cjsatuforc/QsP/README

3D Printer main driver board incorporating Atmel XMEGA. Inspired by RUMBA and other RepRap projects.
