cjsatuforc/QsP/mainboard.pdf

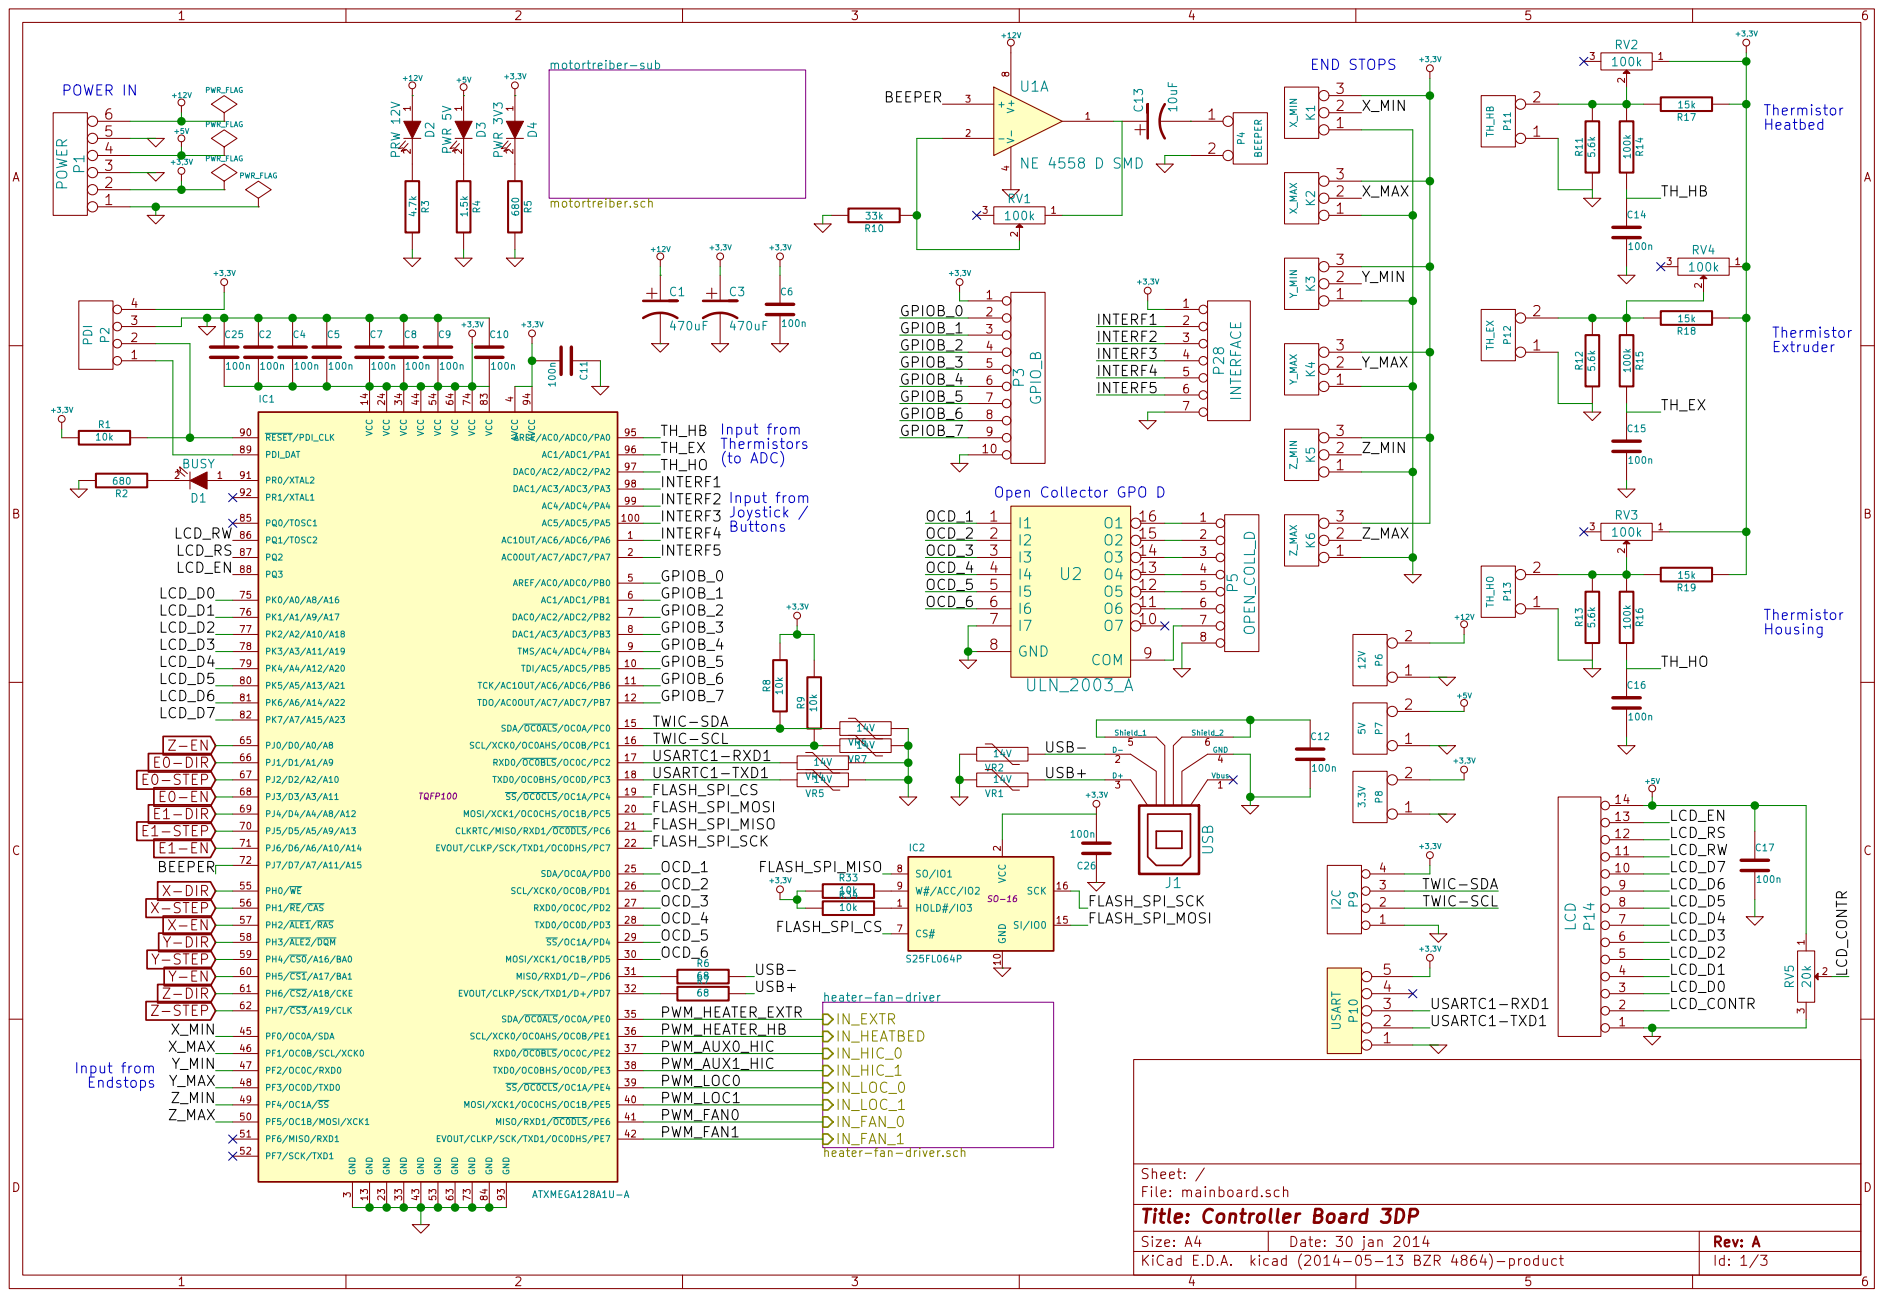
[picture p1: page 1]

+3,3V Thermistor Heatbed Thermistor Extruder Thermistor Housing

INTERF3 | 4
INTERF4 | 5

+12V heater-fan-driver heater-fan-driver.sch

2 CS# 7 SO/IO1 8 W#/ACC/IO2 9 GND 10 SI/IO0 15 SCK 16

PWM_AUX1_HIC
PWM_LOC0
PWM_LOC1
PWM_FAN0

File: mainboard.sch Sheet: /
Id: 1/3 Title: Controller Board 3DP

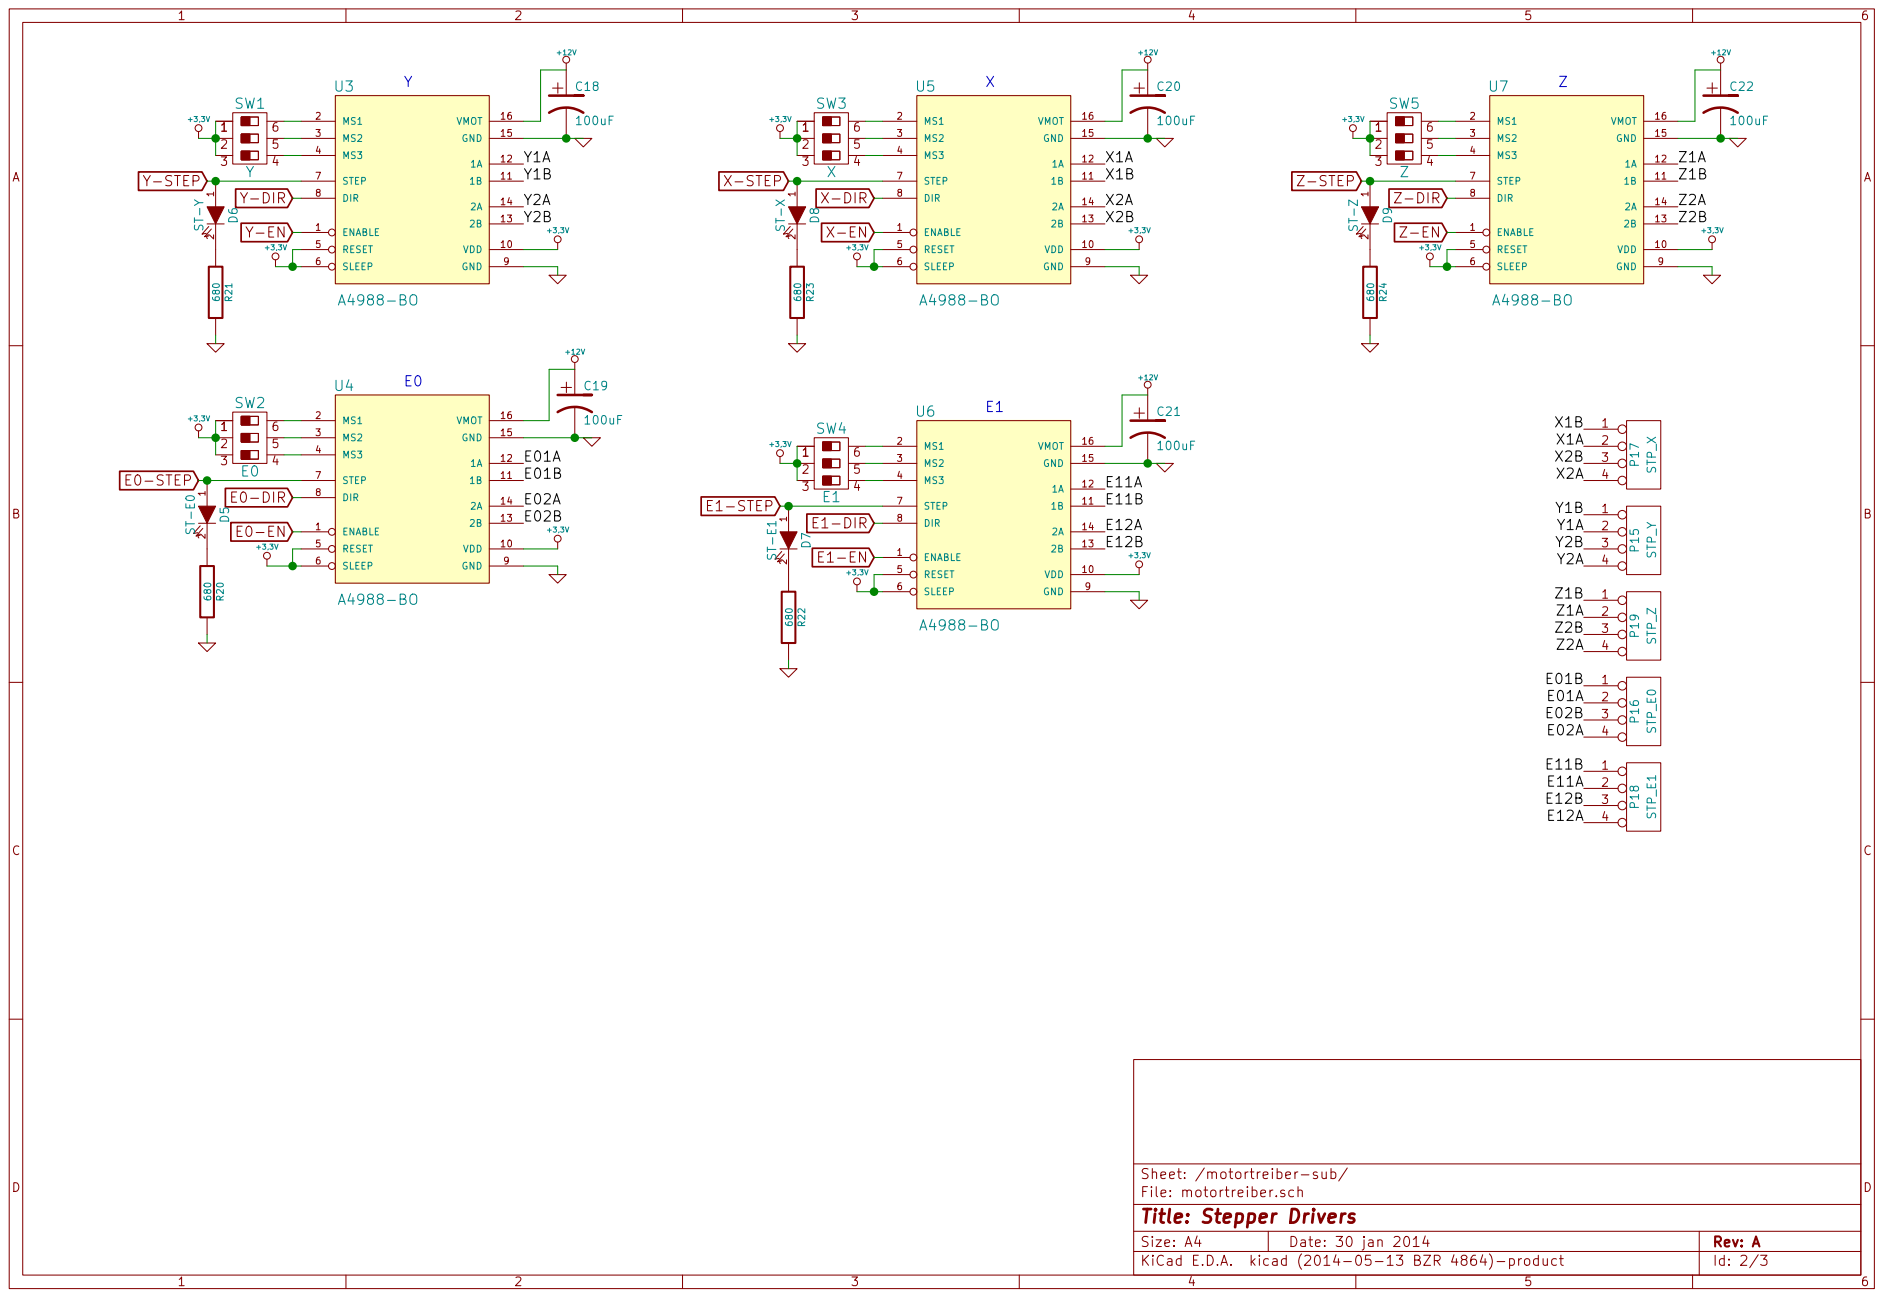
[picture p2: page 2]

File: motortreiber.sch Sheet: /motortreiber-sub/
Id: 2/3 Title: Stepper Drivers

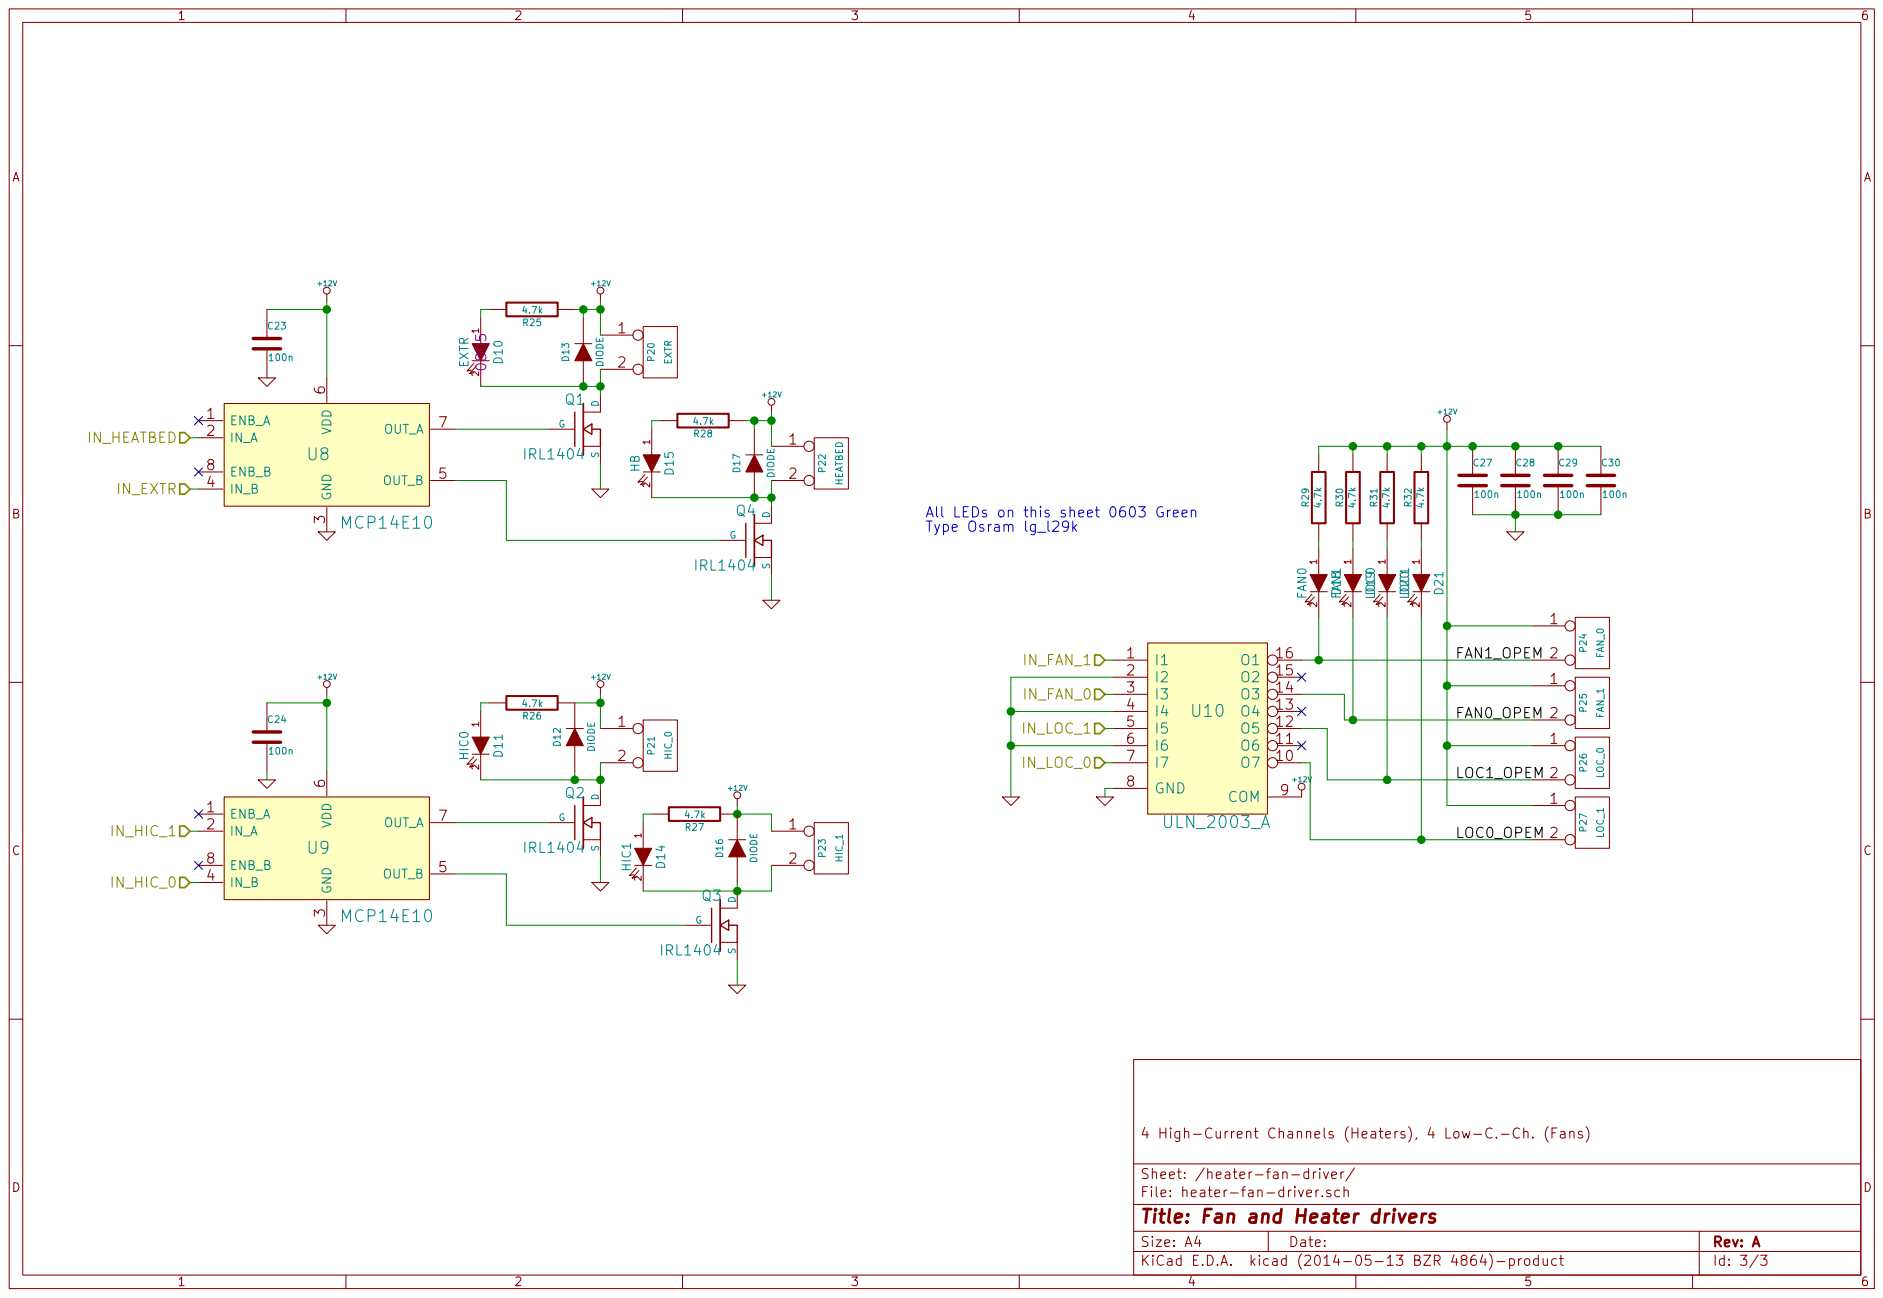
[picture p3: page 3]

All LEDs on this sheet 0603 Green

File: heater-fan-driver.sch Sheet: /heater-fan-driver/ 4 High-Current Channels (Heaters), 4 Low-C.-Ch. (Fans)

Id: 3/3 Title: Fan and Heater drivers
