cjsatuforc/QsP/mainboard-brd.pdf

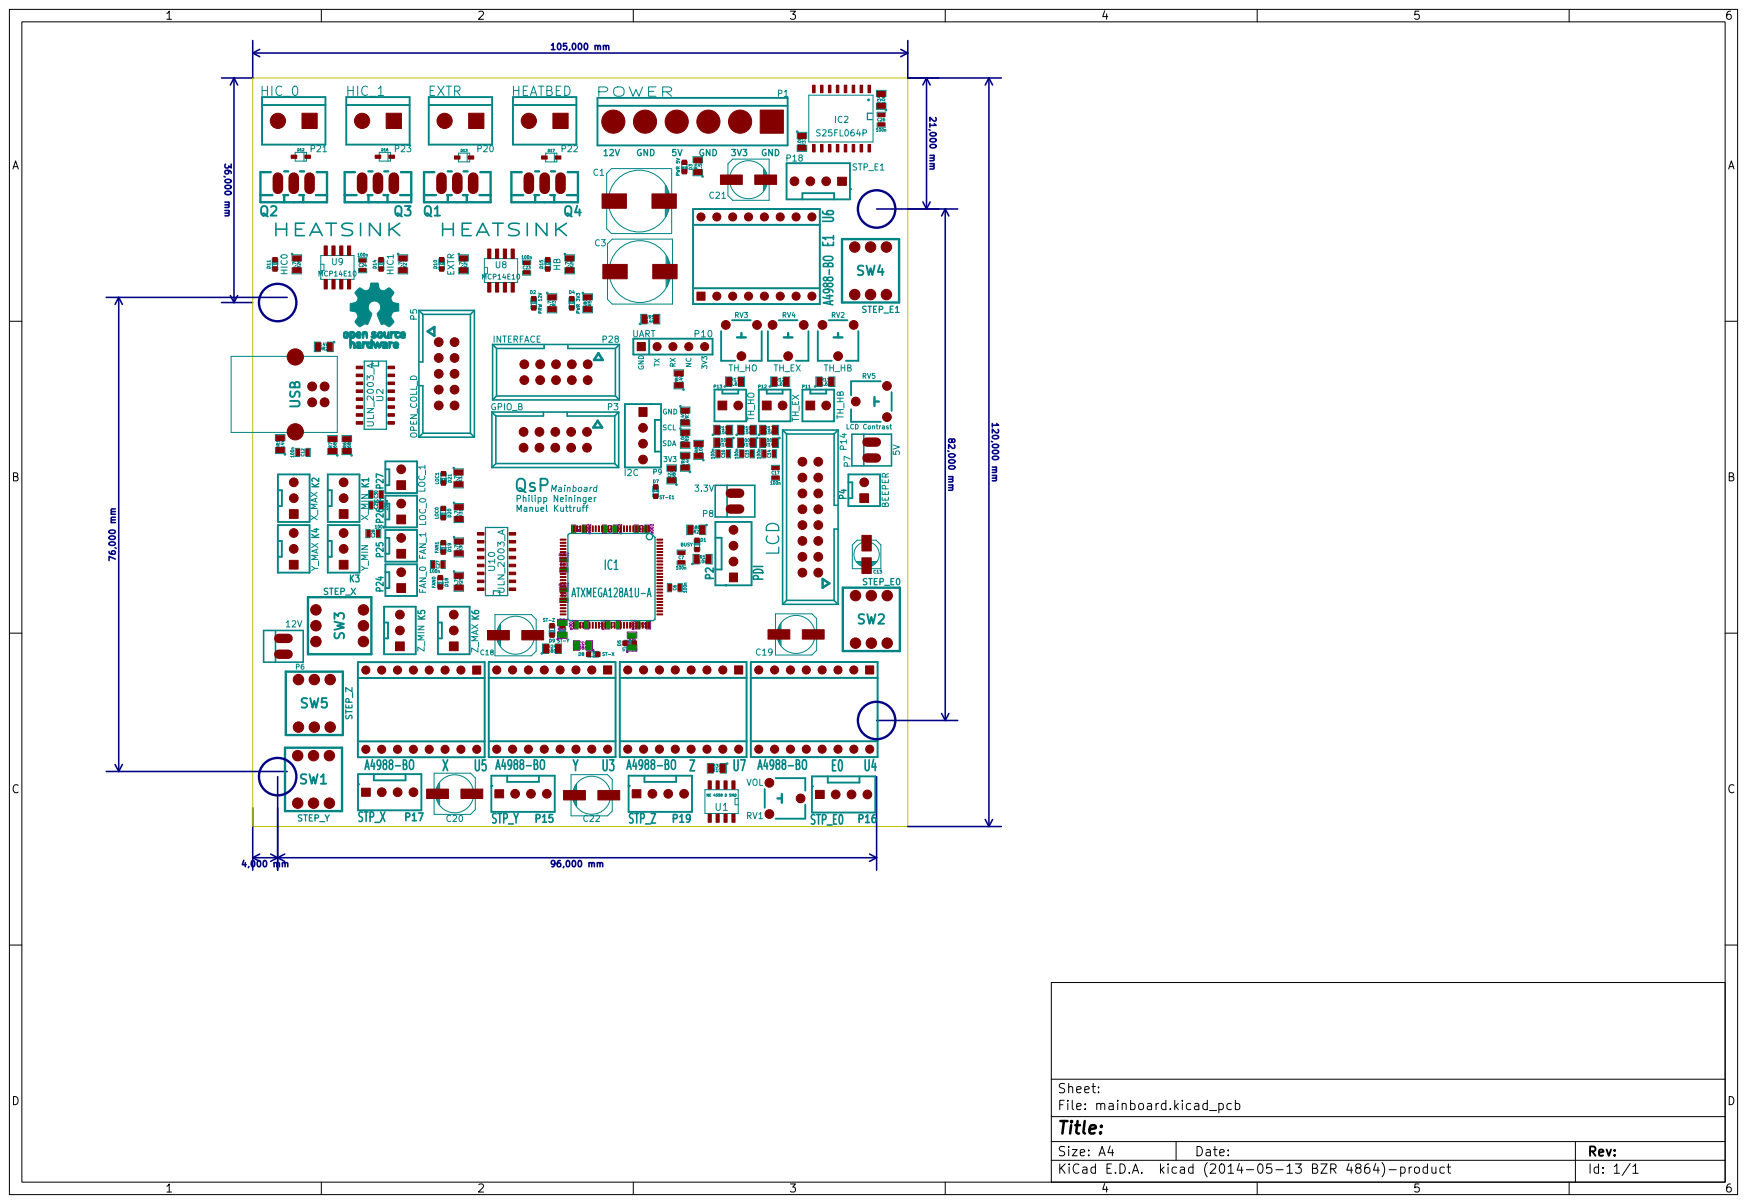
[picture p4: page 1]
