cjsatuforc/QsP/mainboard.kicad_pcb

## KiCad design mainboard.kicad_pcb (2014-08-16)

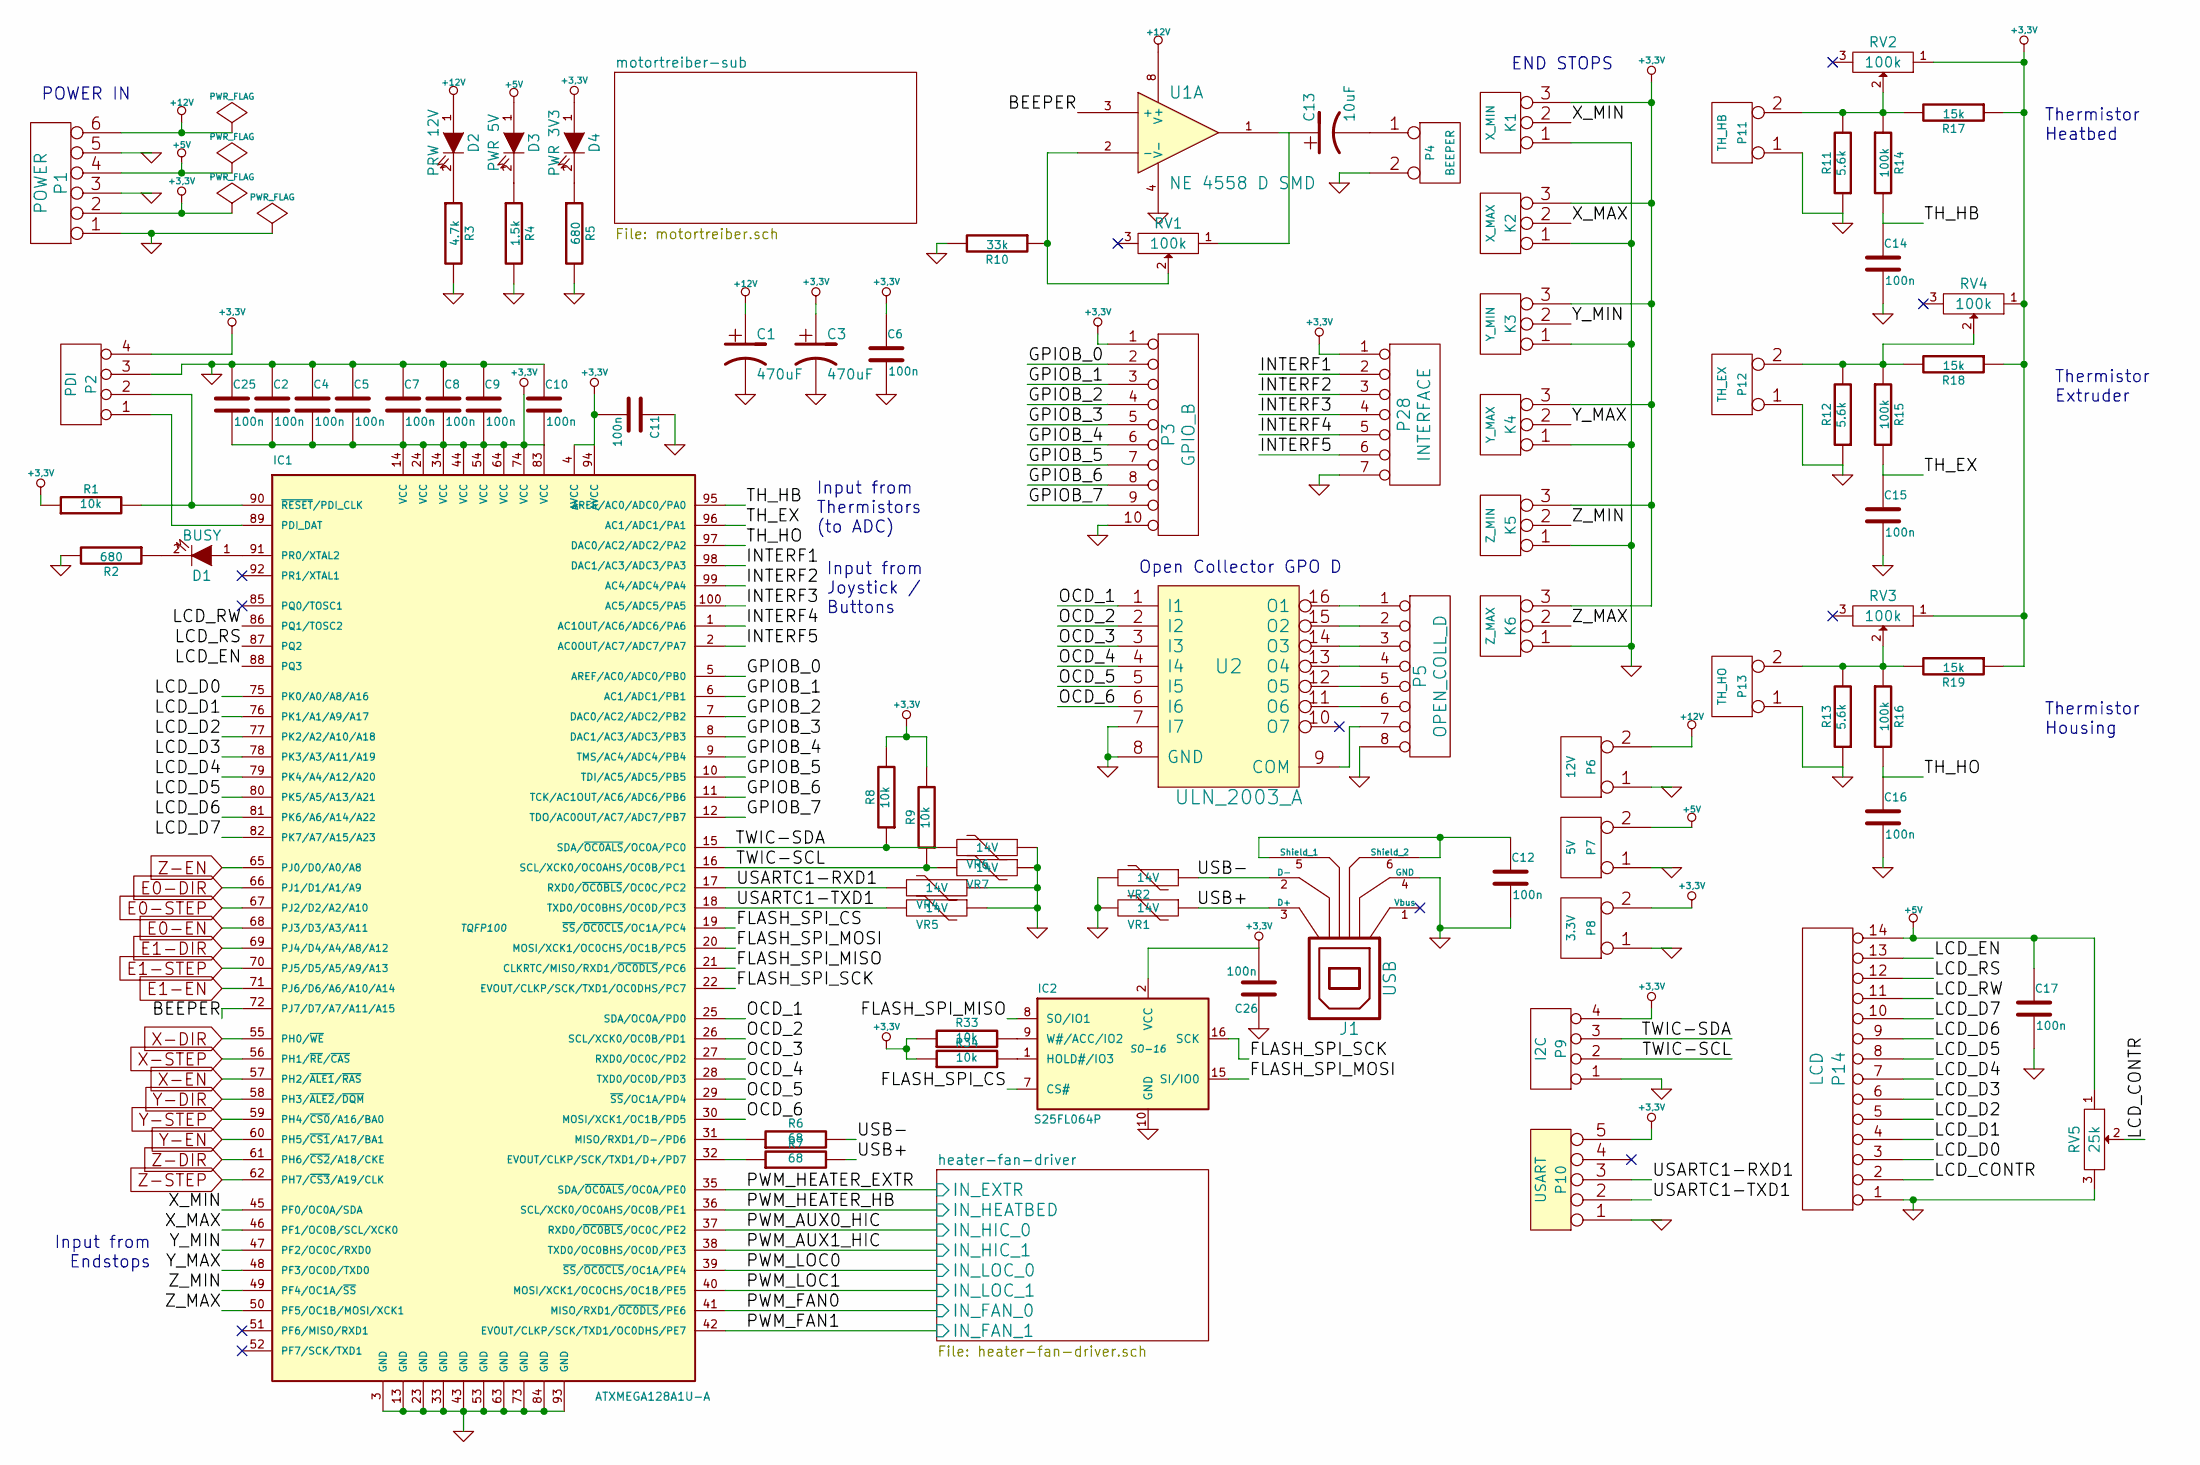
[picture p5: schematic mainboard.sch, Controller Board 3DP]

Parts:
C1, C3: 470uF
C2, C4, C5, C6, C7, C8, C9, C10, C11, C25, C26: 100n
C12, C14, C15, C16, C17: 100n
C13: 10uF
D1: BUSY
D2: PRW 12V
D3: PWR 5V
D4: PWR 3V3
IC1: ATXMEGA128A1U-A; TQFP100
IC2: S25FL064P; SO-16
J1: USB
K1: X_MIN
K2: X_MAX
K3: Y_MIN
K4: Y_MAX
K5: Z_MIN
K6: Z_MAX
P1: POWER
P2: PDI
P3: GPIO_B
P4: BEEPER
P5: OPEN_COLL_D
P6: 12V
P7: 5V
P8: 3.3V
P9: I2C
P10: USART
P11: TH_HB
P12: TH_EX
P13: TH_HO
P14: LCD
P28: INTERFACE
R1: 10k
R2, R5: 680
R3: 4.7k
R4: 1.5k
R6, R7: 68
R8, R9, R33, R34: 10k
R10: 33k
R11, R12, R13: 5.6k
R14, R15, R16: 100k
R17, R18, R19: 15k
RV1, RV2, RV3, RV4: 100k
RV5: 25k
U1: NE 4558 D SMD
U2: ULN_2003_A
VR1, VR2, VR4, VR5, VR6, VR7: 14V

Connections:
+3.3V: C2.2, C3.1, C4.2, C5.2, C6.1, C7.2, C8.2, C9.2, C10.2, C11.2, C25.2, C26.2, D4.1 (A), IC1.4 (AVCC), IC1.14 (VCC), IC1.24 (VCC), IC1.34 (VCC), IC1.44 (VCC), IC1.54 (VCC), IC1.64 (VCC), IC1.74 (VCC), IC1.83 (VCC), IC1.94 (AVCC), IC2.2 (VCC), K1.3, K2.3, K3.3, K4.3, K5.3, K6.3, P1.2, P2.4, P3.1, P8.2 (PM), P9.4, P10.5, P28.1, R1.1, R8.2, R9.2, R17.1, R18.1, R19.1, R33.1, R34.1, RV2.1, RV3.1, RV4.1; also elsewhere on the board
+5V: C17.1, D3.1 (A), P1.4, P7.2 (PM), P14.14, RV5.1
+12V: C1.1, D2.1 (A), P1.6, P6.2 (PM), U1.8 (V+); also elsewhere on the board
/BEEPER: IC1.72 (PJ7/D7/A7/A11/A15), U1.3 (+)
/FLASH_SPI_CS: IC1.19 (~SS~/~OC0CLS~/OC1A/PC4), IC2.7 (CS#)
/FLASH_SPI_MISO: IC1.21 (CLKRTC/MISO/RXD1/~OC0DLS~/PC6), IC2.8 (SO/IO1)
/FLASH_SPI_MOSI: IC1.20 (MOSI/XCK1/OC0CHS/OC1B/PC5), IC2.15 (SI/IO0)
/FLASH_SPI_SCK: IC1.22 (EVOUT/CLKP/SCK/TXD1/OC0DHS/PC7), IC2.16 (SCK)
/GPIOB_0: IC1.5 (AREF/AC0/ADC0/PB0), P3.2
/GPIOB_1: IC1.6 (AC1/ADC1/PB1), P3.3
/GPIOB_2: IC1.7 (DAC0/AC2/ADC2/PB2), P3.4
/GPIOB_3: IC1.8 (DAC1/AC3/ADC3/PB3), P3.5
/GPIOB_4: IC1.9 (TMS/AC4/ADC4/PB4), P3.6
/GPIOB_5: IC1.10 (TDI/AC5/ADC5/PB5), P3.7
/GPIOB_6: IC1.11 (TCK/AC1OUT/AC6/ADC6/PB6), P3.8
/GPIOB_7: IC1.12 (TDO/AC0OUT/AC7/ADC7/PB7), P3.9
/INTERF1: IC1.98 (DAC1/AC3/ADC3/PA3), P28.2
/INTERF2: IC1.99 (AC4/ADC4/PA4), P28.3
/INTERF3: IC1.100 (AC5/ADC5/PA5), P28.4
/INTERF4: IC1.1 (AC1OUT/AC6/ADC6/PA6), P28.5
/INTERF5: IC1.2 (AC0OUT/AC7/ADC7/PA7), P28.6
/LCD_CONTR: P14.2, RV5.2
/LCD_D0: IC1.75 (PK0/A0/A8/A16), P14.3
/LCD_D1: IC1.76 (PK1/A1/A9/A17), P14.4
/LCD_D2: IC1.77 (PK2/A2/A10/A18), P14.5
/LCD_D3: IC1.78 (PK3/A3/A11/A19), P14.6
/LCD_D4: IC1.79 (PK4/A4/A12/A20), P14.7
/LCD_D5: IC1.80 (PK5/A5/A13/A21), P14.8
/LCD_D6: IC1.81 (PK6/A6/A14/A22), P14.9
/LCD_D7: IC1.82 (PK7/A7/A15/A23), P14.10
/LCD_EN: IC1.88 (PQ3), P14.13
/LCD_RS: IC1.87 (PQ2), P14.12
/LCD_RW: IC1.86 (PQ1/TOSC2), P14.11
/OCD_1: IC1.25 (SDA/OC0A/PD0), U2.1 (I1)
/OCD_2: IC1.26 (SCL/XCK0/OC0B/PD1), U2.2 (I2)
/OCD_3: IC1.27 (RXD0/OC0C/PD2), U2.3 (I3)
/OCD_4: IC1.28 (TXD0/OC0D/PD3), U2.4 (I4)
/OCD_5: IC1.29 (~SS~/OC1A/PD4), U2.5 (I5)
/OCD_6: IC1.30 (MOSI/XCK1/OC1B/PD5), U2.6 (I6)
/TH_EX: C15.1, IC1.96 (AC1/ADC1/PA1), R15.2
/TH_HB: C14.1, IC1.95 (AREF/AC0/ADC0/PA0), R14.2
/TH_HO: C16.1, IC1.97 (DAC0/AC2/ADC2/PA2), R16.2
/TWIC-SCL: IC1.16 (SCL/XCK0/OC0AHS/OC0B/PC1), P9.2, R9.1, VR7.2
/TWIC-SDA: IC1.15 (SDA/~OC0ALS~/OC0A/PC0), P9.3, R8.1, VR6.2
/USARTC1-RXD1: IC1.17 (RXD0/~OC0BLS~/OC0C/PC2), P10.3, VR4.2
/USARTC1-TXD1: IC1.18 (TXD0/OC0BHS/OC0D/PC3), P10.2, VR5.2
/USB+: J1.3 (D+), R7.2, VR1.1
/USB-: J1.2 (D-), R6.2, VR2.1
/X_MAX: IC1.46 (PF1/OC0B/SCL/XCK0), K2.2 (PM)
/X_MIN: IC1.45 (PF0/OC0A/SDA), K1.2 (PM)
/Y_MAX: IC1.48 (PF3/OC0D/TXD0), K4.2 (PM)
/Y_MIN: IC1.47 (PF2/OC0C/RXD0), K3.2 (PM)
/Z_MAX: IC1.50 (PF5/OC1B/MOSI/XCK1), K6.2 (PM)
/Z_MIN: IC1.49 (PF4/OC1A/~SS~), K5.2 (PM)
/heater-fan-driver/IN_EXTR: IC1.35 (SDA/~OC0ALS~/OC0A/PE0); also elsewhere on the board
/heater-fan-driver/IN_FAN_0: IC1.41 (MISO/RXD1/~OC0DLS~/PE6); also elsewhere on the board
/heater-fan-driver/IN_FAN_1: IC1.42 (EVOUT/CLKP/SCK/TXD1/OC0DHS/PE7); also elsewhere on the board
/heater-fan-driver/IN_HEATBED: IC1.36 (SCL/XCK0/OC0AHS/OC0B/PE1); also elsewhere on the board
/heater-fan-driver/IN_HIC_0: IC1.37 (RXD0/~OC0BLS~/OC0C/PE2); also elsewhere on the board
/heater-fan-driver/IN_HIC_1: IC1.38 (TXD0/OC0BHS/OC0D/PE3); also elsewhere on the board
/heater-fan-driver/IN_LOC_0: IC1.39 (~SS~/~OC0CLS~/OC1A/PE4); also elsewhere on the board
/heater-fan-driver/IN_LOC_1: IC1.40 (MOSI/XCK1/OC0CHS/OC1B/PE5); also elsewhere on the board
E0-DIR: IC1.66 (PJ1/D1/A1/A9); also elsewhere on the board
E0-EN: IC1.68 (PJ3/D3/A3/A11); also elsewhere on the board
E0-STEP: IC1.67 (PJ2/D2/A2/A10); also elsewhere on the board
E1-DIR: IC1.69 (PJ4/D4/A4/A8/A12); also elsewhere on the board
E1-EN: IC1.71 (PJ6/D6/A6/A10/A14); also elsewhere on the board
E1-STEP: IC1.70 (PJ5/D5/A5/A9/A13); also elsewhere on the board
GND: C1.2, C2.1, C3.2, C4.1, C5.1, C6.2, C7.1, C8.1, C9.1, C10.1, C11.1, C12.2, C14.2, C15.2, C16.2, C17.2, C25.1, C26.1, IC1.3 (GND), IC1.13 (GND), IC1.23 (GND), IC1.33 (GND), IC1.43 (GND), IC1.53 (GND), IC1.63 (GND), IC1.73 (GND), IC1.84 (GND), IC1.93 (GND), IC2.10 (GND), J1.4 (GND), K1.1, K2.1, K3.1, K4.1, K5.1, K6.1, P1.1, P1.3, P1.5, P2.3, P3.10, P4.2 (PM), P5.8, P6.1, P7.1, P8.1, P9.1, P10.1, P11.1, P12.1, P13.1, P14.1, P28.7, R2.2, R3.2, R4.2, R5.2, R10.2, R11.1, R12.1, R13.1, RV5.3, U1.4 (V-), U2.7 (I7), U2.8 (GND), VR1.2, VR2.2, VR4.1, VR5.1, VR6.1, VR7.1; also elsewhere on the board
unnamed: C12.1, J1.5 (Shield_1), J1.6 (Shield_2)
unnamed: C13.1, RV1.1, U1.1
unnamed: C13.2, P4.1
unnamed: D1.1 (A), IC1.91 (PR0/XTAL2)
unnamed: D1.2 (K), R2.1
unnamed: D2.2 (K), R3.1
unnamed: D3.2 (K), R4.1
unnamed: D4.2 (K), R5.1
unnamed: IC1.31 (MISO/RXD1/D-/PD6), R6.1
unnamed: IC1.32 (EVOUT/CLKP/SCK/TXD1/D+/PD7), R7.1
unnamed: IC1.89 (PDI_DAT), P2.1
unnamed: IC1.90 (~RESET~/PDI_CLK), P2.2, R1.2
unnamed: IC2.1 (HOLD#/IO3), R34.2
unnamed: IC2.9 (W#/ACC/IO2), R33.2
unnamed: P5.1, U2.16 (O1)
unnamed: P5.2, U2.15 (O2)
unnamed: P5.3, U2.14 (O3)
unnamed: P5.4, U2.13 (O4)
unnamed: P5.5, U2.12 (O5)
unnamed: P5.6, U2.11 (O6)
unnamed: P5.7, U2.9 (COM)
unnamed: P11.2 (PM), R11.2, R14.1, R17.2, RV2.2
unnamed: P12.2 (PM), R12.2, R15.1, R18.2, RV4.2
unnamed: P13.2 (PM), R13.2, R16.1, R19.2, RV3.2
unnamed: R10.1, RV1.2, U1.2 (-)
X-DIR: IC1.55 (PH0/~WE); also elsewhere on the board
X-EN: IC1.57 (PH2/~ALE1~/~RAS~); also elsewhere on the board
X-STEP: IC1.56 (PH1/~RE~/~CAS~); also elsewhere on the board
Y-DIR: IC1.58 (PH3/~ALE2~/~DQM~); also elsewhere on the board
Y-EN: IC1.60 (PH5/~CS1~/A17/BA1); also elsewhere on the board
Y-STEP: IC1.59 (PH4/~CS0~/A16/BA0); also elsewhere on the board
Z-DIR: IC1.61 (PH6/~CS2~/A18/CKE); also elsewhere on the board
Z-EN: IC1.65 (PJ0/D0/A0/A8); also elsewhere on the board
Z-STEP: IC1.62 (PH7/~CS3~/A19/CLK); also elsewhere on the board

Notes on the sheet:
POWER IN
END STOPS
Thermistor Heatbed
Thermistor Extruder
Thermistor Housing
Input from Endstops
Input from Thermistors (to ADC)
Input from Joystick / Buttons
Open Collector GPO D

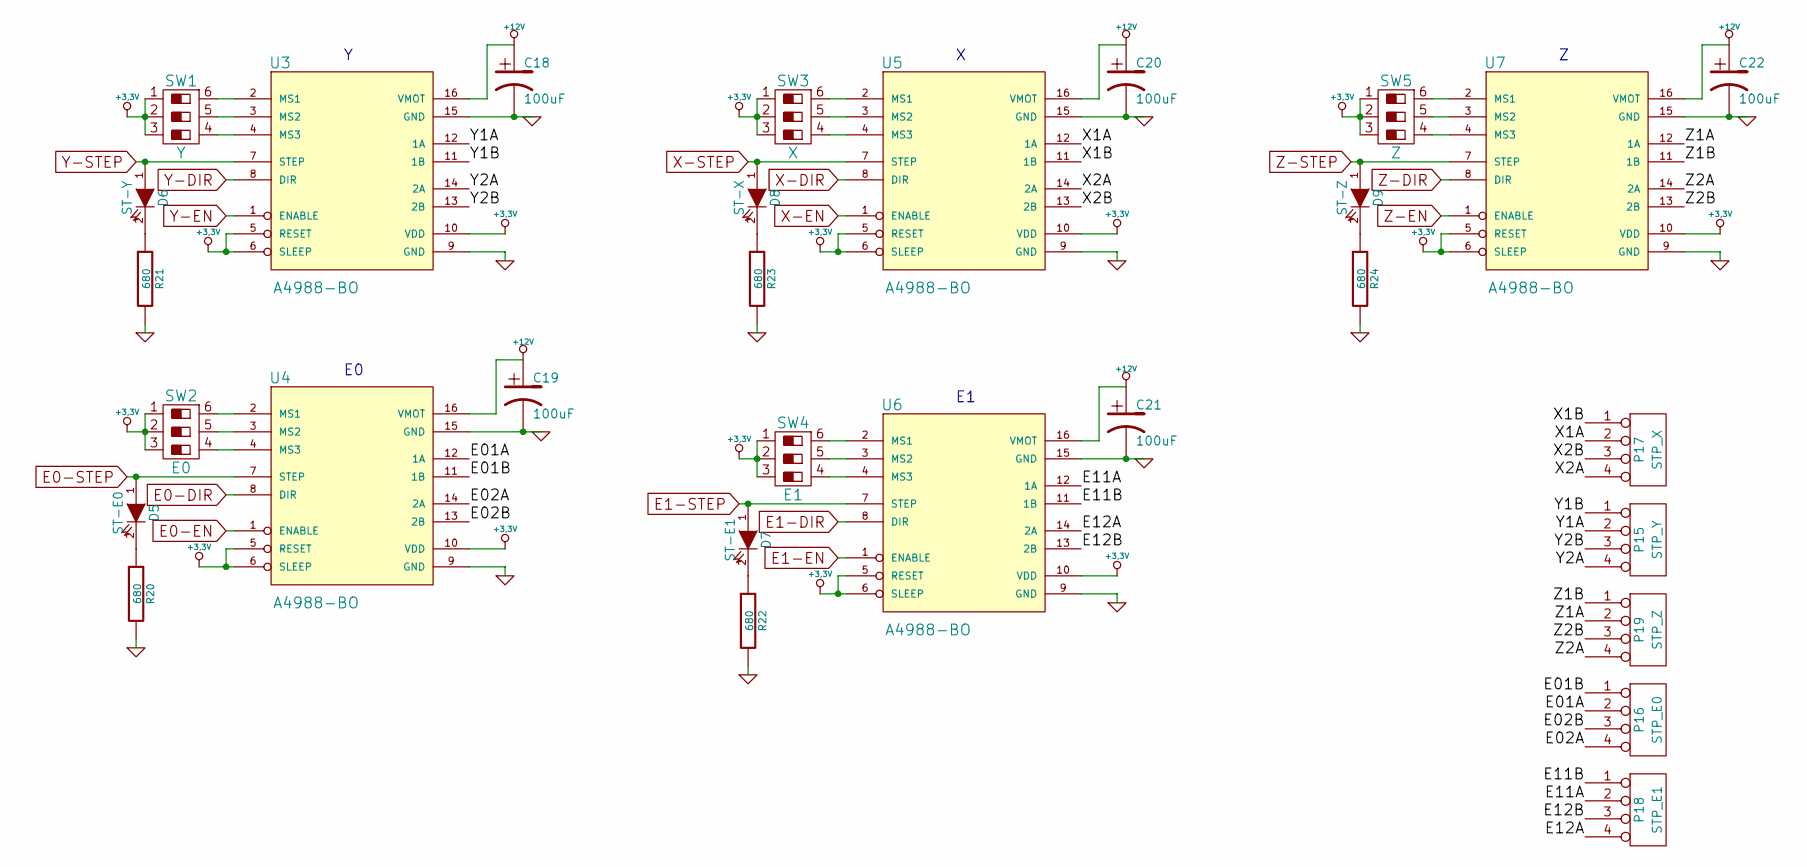
[picture p6: schematic motortreiber.sch, Stepper Drivers]

Parts:
C18, C19, C20, C21, C22: 100uF
D5: ST-E0
D6: ST-Y
D7: ST-E1
D8: ST-X
D9: ST-Z
P15: STP_Y
P16: STP_E0
P17: STP_X
P18: STP_E1
P19: STP_Z
R20, R21, R22, R23, R24: 680
SW1: Y
SW2: E0
SW3: X
SW4: E1
SW5: Z
U3, U4, U5, U6, U7: A4988-BO

Connections:
+3.3V: SW1.1, SW1.2, SW1.3, SW2.1, SW2.2, SW2.3, SW3.1, SW3.2, SW3.3, SW4.1, SW4.2, SW4.3, SW5.1, SW5.2, SW5.3, U3.5 (RESET), U3.6 (SLEEP), U3.10 (VDD), U4.5 (RESET), U4.6 (SLEEP), U4.10 (VDD), U5.5 (RESET), U5.6 (SLEEP), U5.10 (VDD), U6.5 (RESET), U6.6 (SLEEP), U6.10 (VDD), U7.5 (RESET), U7.6 (SLEEP), U7.10 (VDD); also elsewhere on the board
+12V: C18.1, C19.1, C20.1, C21.1, C22.1, U3.16 (VMOT), U4.16 (VMOT), U5.16 (VMOT), U6.16 (VMOT), U7.16 (VMOT); also elsewhere on the board
/motortreiber-sub/E01A: P16.2, U4.12 (1A)
/motortreiber-sub/E01B: P16.1, U4.11 (1B)
/motortreiber-sub/E02A: P16.4, U4.14 (2A)
/motortreiber-sub/E02B: P16.3, U4.13 (2B)
/motortreiber-sub/E11A: P18.2, U6.12 (1A)
/motortreiber-sub/E11B: P18.1, U6.11 (1B)
/motortreiber-sub/E12A: P18.4, U6.14 (2A)
/motortreiber-sub/E12B: P18.3, U6.13 (2B)
/motortreiber-sub/X1A: P17.2, U5.12 (1A)
/motortreiber-sub/X1B: P17.1, U5.11 (1B)
/motortreiber-sub/X2A: P17.4, U5.14 (2A)
/motortreiber-sub/X2B: P17.3, U5.13 (2B)
/motortreiber-sub/Y1A: P15.2, U3.12 (1A)
/motortreiber-sub/Y1B: P15.1, U3.11 (1B)
/motortreiber-sub/Y2A: P15.4, U3.14 (2A)
/motortreiber-sub/Y2B: P15.3, U3.13 (2B)
/motortreiber-sub/Z1A: P19.2, U7.12 (1A)
/motortreiber-sub/Z1B: P19.1, U7.11 (1B)
/motortreiber-sub/Z2A: P19.4, U7.14 (2A)
/motortreiber-sub/Z2B: P19.3, U7.13 (2B)
E0-DIR: U4.8 (DIR); also elsewhere on the board
E0-EN: U4.1 (ENABLE); also elsewhere on the board
E0-STEP: D5.1 (A), U4.7 (STEP); also elsewhere on the board
E1-DIR: U6.8 (DIR); also elsewhere on the board
E1-EN: U6.1 (ENABLE); also elsewhere on the board
E1-STEP: D7.1 (A), U6.7 (STEP); also elsewhere on the board
GND: C18.2, C19.2, C20.2, C21.2, C22.2, R20.2, R21.2, R22.2, R23.2, R24.2, U3.9 (GND), U3.15 (GND), U4.9 (GND), U4.15 (GND), U5.9 (GND), U5.15 (GND), U6.9 (GND), U6.15 (GND), U7.9 (GND), U7.15 (GND); also elsewhere on the board
unnamed: D5.2 (K), R20.1
unnamed: D6.2 (K), R21.1
unnamed: D7.2 (K), R22.1
unnamed: D8.2 (K), R23.1
unnamed: D9.2 (K), R24.1
unnamed: SW1.4, U3.4 (MS3)
unnamed: SW1.5, U3.3 (MS2)
unnamed: SW1.6, U3.2 (MS1)
unnamed: SW2.4, U4.4 (MS3)
unnamed: SW2.5, U4.3 (MS2)
unnamed: SW2.6, U4.2 (MS1)
unnamed: SW3.4, U5.4 (MS3)
unnamed: SW3.5, U5.3 (MS2)
unnamed: SW3.6, U5.2 (MS1)
unnamed: SW4.4, U6.4 (MS3)
unnamed: SW4.5, U6.3 (MS2)
unnamed: SW4.6, U6.2 (MS1)
unnamed: SW5.4, U7.4 (MS3)
unnamed: SW5.5, U7.3 (MS2)
unnamed: SW5.6, U7.2 (MS1)
X-DIR: U5.8 (DIR); also elsewhere on the board
X-EN: U5.1 (ENABLE); also elsewhere on the board
X-STEP: D8.1 (A), U5.7 (STEP); also elsewhere on the board
Y-DIR: U3.8 (DIR); also elsewhere on the board
Y-EN: U3.1 (ENABLE); also elsewhere on the board
Y-STEP: D6.1 (A), U3.7 (STEP); also elsewhere on the board
Z-DIR: U7.8 (DIR); also elsewhere on the board
Z-EN: U7.1 (ENABLE); also elsewhere on the board
Z-STEP: D9.1 (A), U7.7 (STEP); also elsewhere on the board

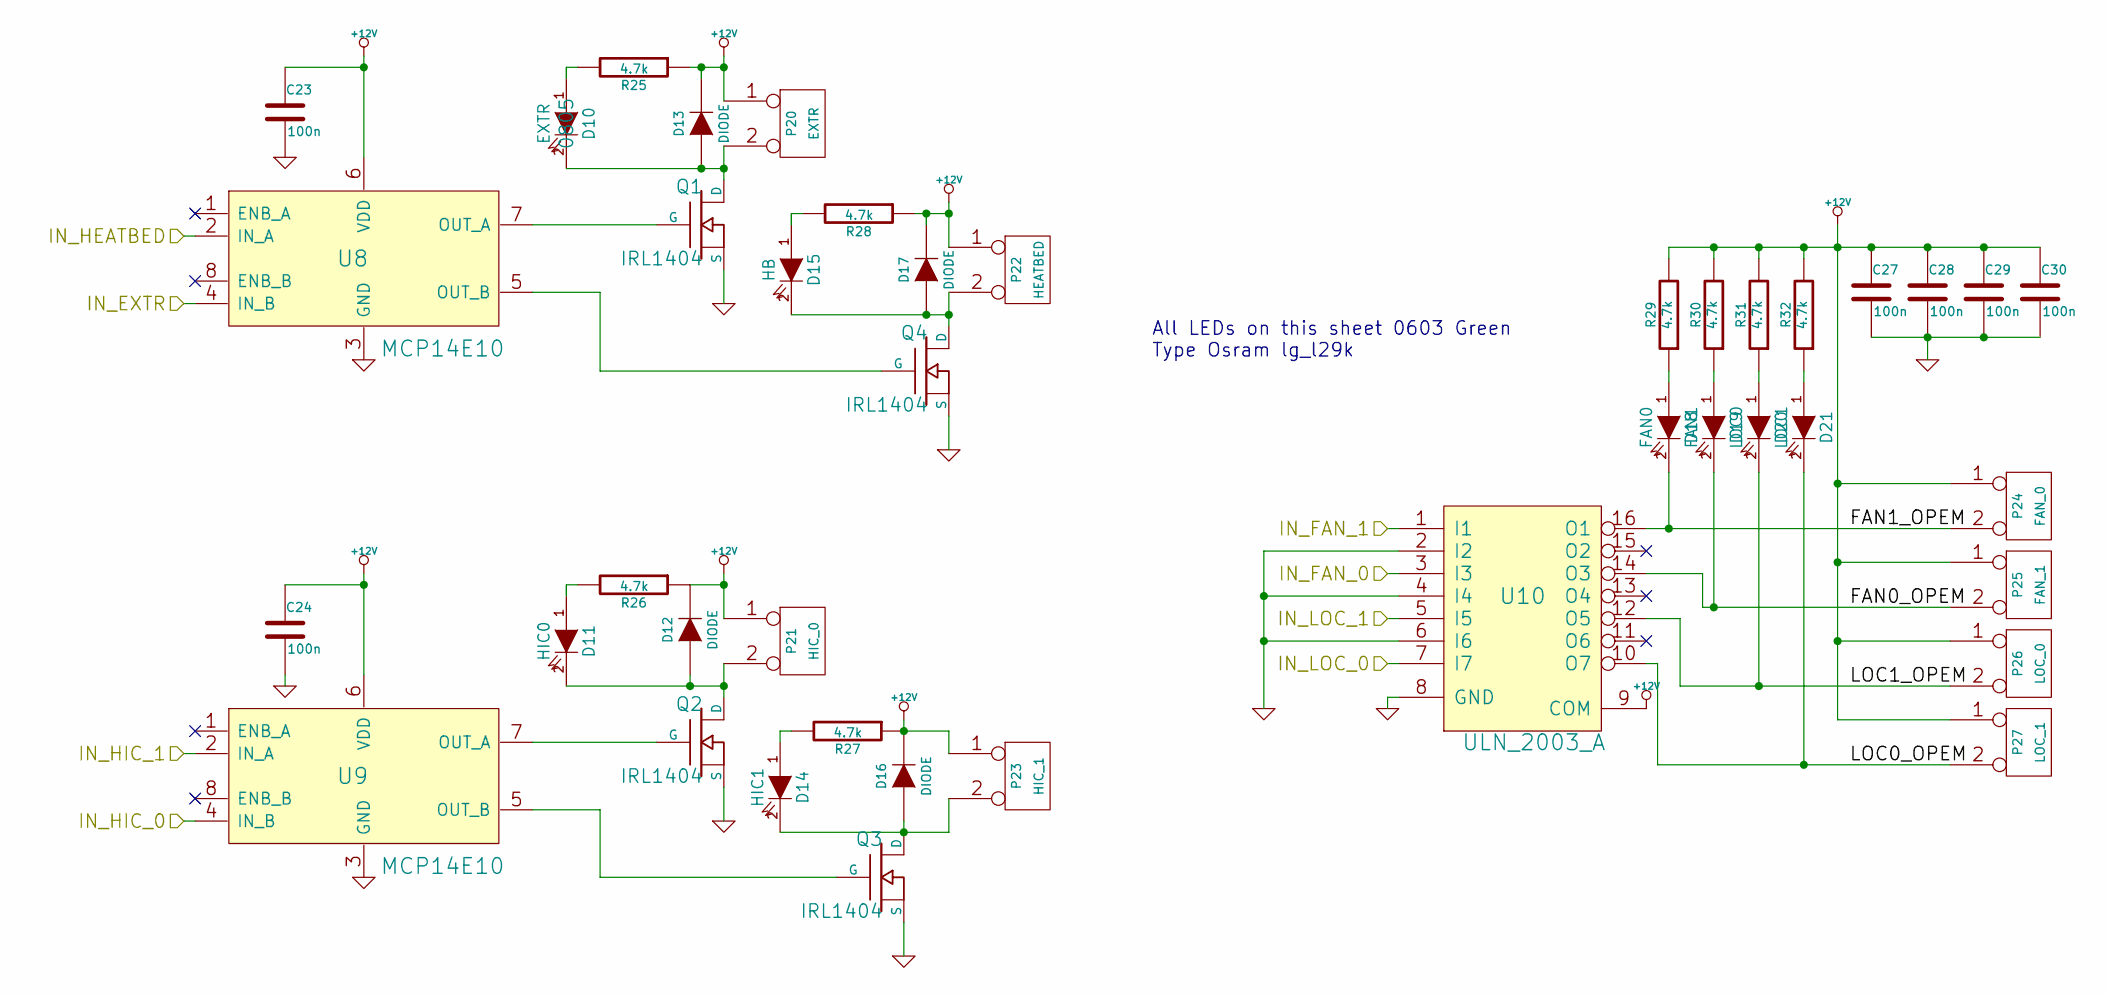
[picture p7: schematic heater-fan-driver.sch, Fan and Heater drivers]

Parts:
C23, C24, C27, C28, C29, C30: 100n
D10: EXTR; 0805
D11: HIC0
D12, D13, D16, D17: DIODE
D14: HIC1
D15: HB
D18: FAN0
D19: FAN1
D20: LOC0
D21: LOC1
P20: EXTR
P21: HIC_0
P22: HEATBED
P23: HIC_1
P24: FAN_0
P25: FAN_1
P26: LOC_0
P27: LOC_1
Q1, Q2, Q3, Q4: IRL1404
R25, R26, R27, R28, R29, R30, R31, R32: 4.7k
U8, U9: MCP14E10
U10: ULN_2003_A

Connections:
+12V: C23.1, C24.1, C27.1, C28.1, C29.1, C30.1, D12.2 (K), D13.2 (K), D16.2 (K), D17.2 (K), P20.1, P21.1, P22.1, P23.1, P24.1, P25.1, P26.1, P27.1, R25.1, R26.1, R27.1, R28.1, R29.2, R30.2, R31.2, R32.2, U8.6 (VDD), U9.6 (VDD), U10.9 (COM); also elsewhere on the board
/heater-fan-driver/FAN0_OPEM: D19.2 (K), P25.2 (PM), U10.14 (O3)
/heater-fan-driver/FAN1_OPEM: D18.2 (K), P24.2 (PM), U10.16 (O1)
/heater-fan-driver/IN_EXTR: U8.4 (IN_B); also elsewhere on the board
/heater-fan-driver/IN_FAN_0: U10.3 (I3); also elsewhere on the board
/heater-fan-driver/IN_FAN_1: U10.1 (I1); also elsewhere on the board
/heater-fan-driver/IN_HEATBED: U8.2 (IN_A); also elsewhere on the board
/heater-fan-driver/IN_HIC_0: U9.4 (IN_B); also elsewhere on the board
/heater-fan-driver/IN_HIC_1: U9.2 (IN_A); also elsewhere on the board
/heater-fan-driver/IN_LOC_0: U10.7 (I7); also elsewhere on the board
/heater-fan-driver/IN_LOC_1: U10.5 (I5); also elsewhere on the board
/heater-fan-driver/LOC0_OPEM: D21.2 (K), P27.2 (PM), U10.10 (O7)
/heater-fan-driver/LOC1_OPEM: D20.2 (K), P26.2 (PM), U10.12 (O5)
GND: C23.2, C24.2, C27.2, C28.2, C29.2, C30.2, Q1.S, Q2.S, Q3.S, Q4.S, U8.3 (GND), U9.3 (GND), U10.2 (I2), U10.4 (I4), U10.6 (I6), U10.8 (GND); also elsewhere on the board
unnamed: D10.1 (A), R25.2
unnamed: D10.2 (K), D13.1 (A), P20.2 (PM), Q1.D
unnamed: D11.1 (A), R26.2
unnamed: D11.2 (K), D12.1 (A), P21.2 (PM), Q2.D
unnamed: D14.1 (A), R27.2
unnamed: D14.2 (K), D16.1 (A), P23.2 (PM), Q3.D
unnamed: D15.1 (A), R28.2
unnamed: D15.2 (K), D17.1 (A), P22.2 (PM), Q4.D
unnamed: D18.1 (A), R29.1
unnamed: D19.1 (A), R30.1
unnamed: D20.1 (A), R31.1
unnamed: D21.1 (A), R32.1
unnamed: Q1.G, U8.7 (OUT_A)
unnamed: Q2.G, U9.7 (OUT_A)
unnamed: Q3.G, U9.5 (OUT_B)
unnamed: Q4.G, U8.5 (OUT_B)

Notes on the sheet:
All LEDs on this sheet 0603 Green Type Osram lg_l29k

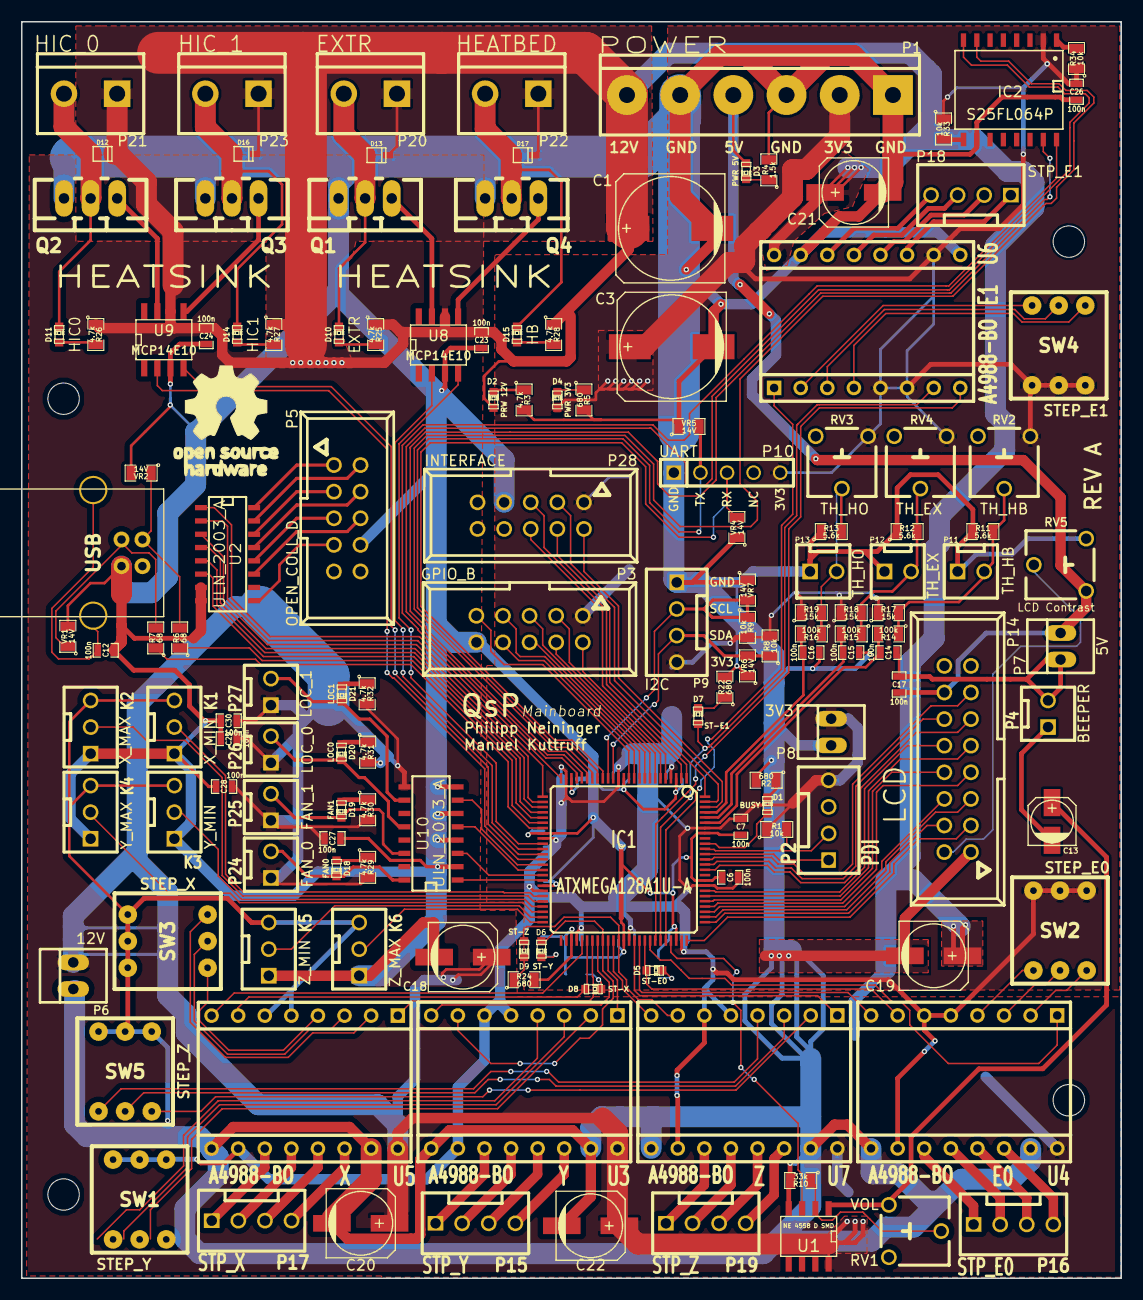
[picture p8: board mainboard.kicad_pcb from above]

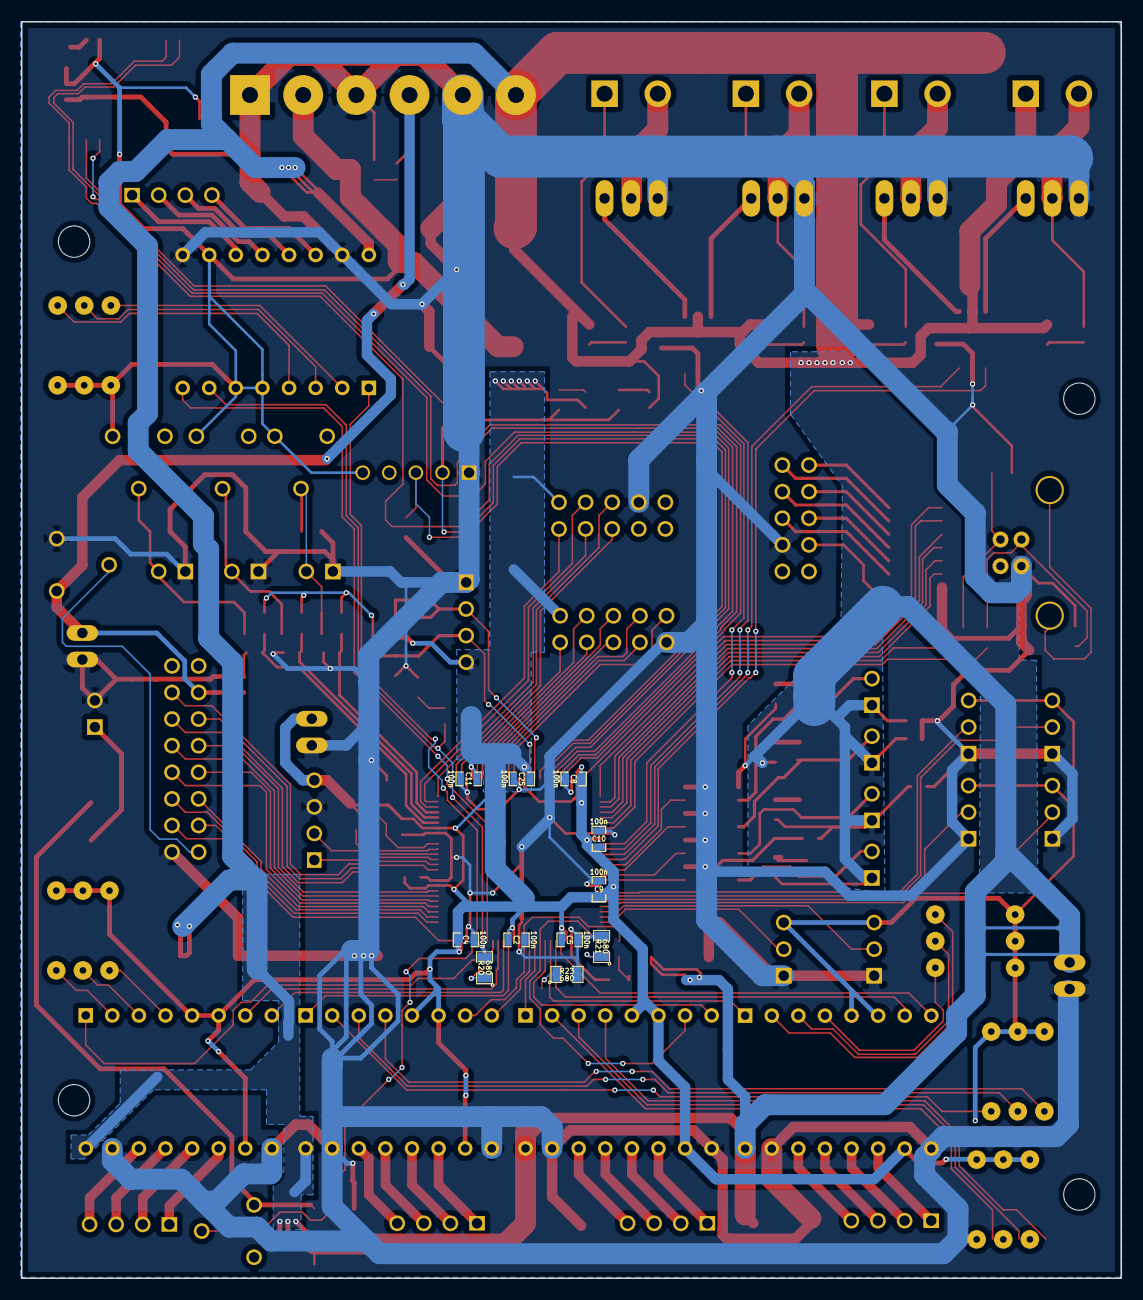
[picture p9: board mainboard.kicad_pcb from below]

Board: 2 copper layers, 105.0 x 120.0 mm, 152 parts (11 on the bottom side), 163 nets.
