cjsatuforc/QsP/(commit log)

2014-03-26 Added notes/toDo file, swapped xMEGA for a model from kicad standard library
    [mainboard.sch, motortreiber.sch]
2014-03-26 Added a bunch of new labels to the microcontroller
    [mainboard.sch]
2014-03-26 removed 1 stepper motor driver (-> to have enough ports left for the LCD), added low pass filters to thermistor inputs
    [mainboard.sch, motortreiber.sch]
2014-03-27 Added LCD connector (pin assignment for connector tbd). Added 555 timer circuit for beeper (400Hz)
    [mainboard.sch]
2014-03-28 Removed 555-Timer-Circuit. Added Opamp to drive beeper.
    [mainboard.sch]
2014-03-29 Changed OpAmp to NE 4558D SMD
    [mainboard.sch]
2014-03-29 Calculated resistor values for thermistor and changed them in the schematic
    [mainboard.sch]
2014-03-30 Added Pot to trim ADC input for thermistors
    [mainboard.sch]
2014-04-15 Changed UC to ATxmega128A1U (TQFP100) which has more pins.
    [mainboard.sch]
2014-04-15 Added USART and I2C connectors, reworked pin mappings for new UC
    [mainboard.sch]
2014-04-16 Added schematic for pwm-drivers. Added ULN 2003 as low current driver.
    [heater-fan-driver.sch, mainboard.sch, motortreiber.sch]
2014-04-17 Added 12V-connector. Changed LCD connector to 14-pin (including d0-d7 now)
    [mainboard.sch]
2014-04-17 Added signal LEDs to hi-current and lo-current drivers, updated BOM
    [heater-fan-driver.sch, mainboard.sch]
2014-04-17 Added Open Collector connector for future expansion
    [mainboard.sch]
2014-04-17 Added potentiometer to make beeper volume adjustable
    [heater-fan-driver.sch, mainboard.sch, motortreiber.sch]
2014-04-18 Added protection diodes for heater drivers Added pcb file (empty yet)
    [heater-fan-driver.sch, mainboard.kicad_pcb]
2014-04-18 Added footprint for a4988 breakout-board
2014-04-18 Input protection for USB, I2C and USART
    [mainboard.sch]
2014-04-19 Added some LEDs for a better overview what the board is doing when operating; Generated netlist and started to associate footprints
    [heater-fan-driver.sch, mainboard.sch, motortreiber.sch]
2014-04-19 Added pullup resistors to I2C interface and protection resistors for USB interface
    [mainboard.sch]
2014-04-19 Added decoupling cap for display supply; Associated most footprints.
    [heater-fan-driver.sch, mainboard.sch, motortreiber.sch]
2014-04-20 Finished footprint association; added footprint for potentiometer
    [heater-fan-driver.sch, mainboard.sch, motortreiber.sch]
2014-04-21 Added status LEDs for 5V and 12V power
    [heater-fan-driver.sch, mainboard.csv, mainboard.sch, motortreiber.sch]
2014-04-21 Added missing interface connector; reworked schematic. Started to layout PCB
    [mainboard.kicad_pcb, mainboard.sch]
2014-04-21 Reworked schematic
    [mainboard.kicad_pcb, mainboard.sch]
2014-04-22 * Changed connectors to PSK type - this prevents plugging the steppers in the wrong way * Changed stepping increment jumpers to DIP-switches - easier setting
    [heater-fan-driver.sch, mainboard.kicad_pcb, mainboard.sch, motortreiber.sch]
2014-04-22 * Added PSK-2 connector to library * Changed Low-Current outputs (FANs etc) to PSK-2 connectors
    [mainboard.kicad_pcb]
2014-04-22 Added footprint for SOD323 diode package and replaced former MELF-package
    [mainboard.kicad_pcb]
2014-04-22 Changed USART connector to show the respective net each pin is connected to
    [mainboard.csv, mainboard.kicad_pcb]
2014-04-23 * Removed numerous errors, schematic now passes ERC test. * Arranged footprints on PCB to prepare for routing
    [heater-fan-driver.sch, mainboard.kicad_pcb, mainboard.sch, motortreiber.sch]
2014-04-24 Added decoupling caps for MOSFET drivers
    [heater-fan-driver.sch, mainboard.kicad_pcb]
2014-04-26 * Changed order of stepper connections to UC to ease PCB routing * Arranged all items in 12x12cm space, ready to route(?)
    [mainboard.kicad_pcb, mainboard.sch]
2014-05-02 * Schematic: Added decoupling cap for XMega * Schematic: Changed connector pin assignment for easier routing * Board: Changed arrangement of some components * Board: Routed all signal nets. To Do: Po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
    [heater-fan-driver.sch, mainboard.kicad_pcb, mainboard.sch, motortreiber.sch]
2014-05-03 Router parts of the power layer
    [mainboard.kicad_pcb]
2014-05-06 Added board outline
    [mainboard.kicad_pcb]
2014-05-13 * Added 64Mbit Flash Memory to schematic * Finalized power routing
    [heater-fan-driver.sch, mainboard.kicad_pcb, mainboard.sch, motortreiber.sch]
2014-05-13 Changed ground plane clearance
    [mainboard.kicad_pcb]
2014-05-14 * top layer: added filled areas, other optimizations * changed drills, removed bottom solder mask from some through-hole components to make them solderable * added OSHW logo and moved some labels to 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
    [mainboard-B_Cu.gbl, mainboard-B_Mask.gbs, mainboard-B_SilkS.gbo, mainboard-Cmts_User.gbr, mainboard-Dwgs_User.gbr, mainboard-Eco1_User.gbr, mainboard-Eco2_User.gbr, mainboard-Edge_Cuts.gbr]
2014-08-16 * Added goals for REV B * More room for mounting hole (bottom left)
    [mainboard.csv, mainboard.kicad_pcb, mainboard.sch]
